omarafif-ee/400V-SiC-Half-Bridge-Driver/Manufacturing/BOM.csv

Reference | Qty | Value | Exclude from Position Files | Footprint | Datasheet | # | Part Number | Manufacturer
C1,C4,C6 | 3 | 100nF | ${EXCLUDE_FROM_POS_FILES} | Capacitor_SMD:C_0805_2012Metric |  | 1 | GRM21BR71H104KA01L | Murata
C2,C5,C7 | 3 | 1uF | ${EXCLUDE_FROM_POS_FILES} | Capacitor_SMD:C_0805_2012Metric |  | 2 | GRM21BR71H105KA12L | Murata
C3 | 1 | 2.2nF | ${EXCLUDE_FROM_POS_FILES} | Capacitor_SMD:C_0805_2012Metric |  | 3 | GRM21BR71H222KA01L | Murata
C8 | 1 | 100nF | ${EXCLUDE_FROM_POS_FILES} | Capacitor_THT:C_Rect_L18.0mm_W6.0mm_P15.00mm_FKS3_FKP3 |  | 4 | MKP1J031004B00KSSD | WIMA
D1 | 1 | UF4007 | ${EXCLUDE_FROM_POS_FILES} | Diode_THT:D_DO-41_SOD81_P10.16mm_Horizontal |  | 5 | UF4007 | Generic
D2,D3 | 2 | 1N5819HW | ${EXCLUDE_FROM_POS_FILES} | Diode_SMD:D_SOD-123 |  | 6 | 1N5819HW | Generic
J1 | 1 | Conn_01x02 | ${EXCLUDE_FROM_POS_FILES} | Connector_PinHeader_2.54mm:PinHeader_1x02_P2.54mm_Vertical |  | 7 | 1x02 Male Header 2.54mm | Generic
J2 | 1 | Conn_01x04 | ${EXCLUDE_FROM_POS_FILES} | Connector_PinHeader_2.54mm:PinHeader_1x04_P2.54mm_Vertical |  | 8 | 1x04 Male Header 2.54mm | Generic
J3 | 1 | 1766136 | ${EXCLUDE_FROM_POS_FILES} | Connector_Phoenix_GMSTB:PhoenixContact_GMSTBA_2,5_3-G-7,62_1x03_P7.62mm_Horizontal |  | 9 | 1766246 | Phoenix Contact
Q1,Q2 | 2 | C3M0120090D | ${EXCLUDE_FROM_POS_FILES} | Package_TO_SOT_THT:TO-247-3_Vertical |  | 10 | C3M0120090D | Wolfspeed
R1 | 1 | 22k | ${EXCLUDE_FROM_POS_FILES} | Resistor_SMD:R_0805_2012Metric |  | 11 | RC0805FR-0722KL | Yageo
R2,R5 | 2 | 10 | ${EXCLUDE_FROM_POS_FILES} | Resistor_SMD:R_0805_2012Metric |  | 12 | RC0805FR-0710RL | Yageo
R3,R6 | 2 | 1 | ${EXCLUDE_FROM_POS_FILES} | Resistor_SMD:R_0805_2012Metric |  | 13 | RC0805FR-071RL | Yageo
R4,R7 | 2 | 10k | ${EXCLUDE_FROM_POS_FILES} | Resistor_SMD:R_0805_2012Metric |  | 14 | RC0805FR-0710KL | Yageo
R8 | 1 | 2.2 | ${EXCLUDE_FROM_POS_FILES} | Resistor_SMD:R_0805_2012Metric |  | 15 | RC0805FR-072R2L | Yageo
R9,R10 | 2 | 220k | ${EXCLUDE_FROM_POS_FILES} | Resistor_THT:R_Axial_DIN0207_L6.3mm_D2.5mm_P10.16mm_Horizontal |  | 16 | MFR-25FTE52-220K | Yageo
U1 | 1 | UCC21520DW | ${EXCLUDE_FROM_POS_FILES} | Package_SO:SOIC-16W_7.5x10.3mm_P1.27mm | http://www.ti.com/lit/ds/symlink/ucc21520.pdf | 17 | UCC21520DW | Texas Instruments
