omarafif-ee/400V-SiC-Half-Bridge-Driver/LTspice_Simulation/SiC_HalfBridge.asc

C8: cap; 100n; Rser=50m
D2: diode; 1N5819
D3: diode; 1N5819
L_load: ind; 200µ; Rser=20
L_loop: ind; 20n; Rser=0.05 Rpar=20
Q1: nmos; C3M0120090D
Q2: nmos; C3M0120090D
R2: res; 10
R3: res; 1
R4: res; 10k
R5: res; 10
R6: res; 1
R7: res; 10k
R9: res; 220k
R10: res; 220k
V_bus: voltage; 400; Rser=0.05
V_OUTA: voltage; PULSE(0 14 1u 15n 15n 4u 10u)
V_OUTB: voltage; PULSE(15 0 0.78u 15n 15n 4.44u 10u)
Named nets: 0, SW_NODE, DC_PLUS, HS_GATE, LS_GATE
.model C3M0120090D VDMOS(Rg=4.7 Vto=2.1 Rd=0.08 Rs=0.04 Rb=0.05 Kp=12 Cgdmax=180p Cgdmin=6p Cgs=310p Cjo=300p Is=1p N=6.5 Vj=4.8 m=0.5 ksubthres=0.1)
.tran 0 20u 0 1n
