omarafif-ee/400V-SiC-Half-Bridge-Driver/Hardware_KiCad/Gate Driver.kicad_pcb

## KiCad design Hardware_KiCad/Gate Driver.kicad_pcb (2026-10-15)

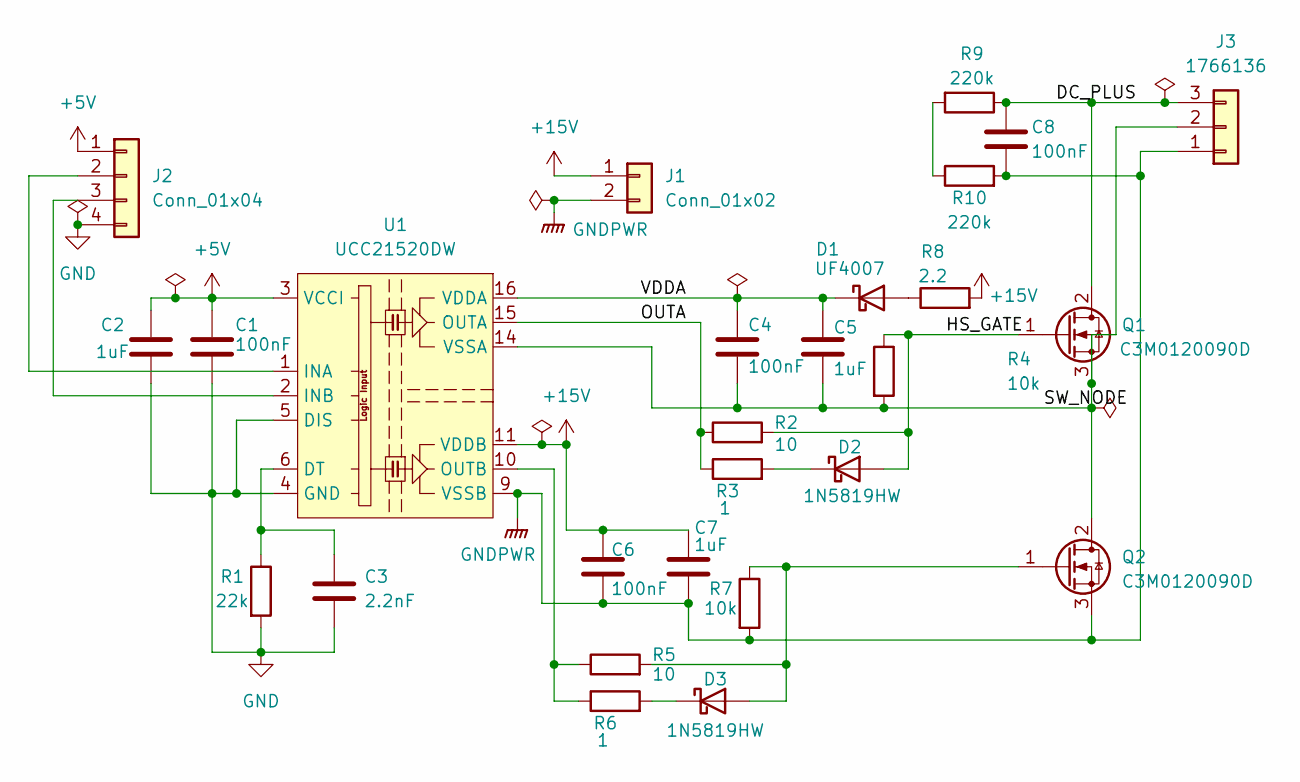
[picture p14: schematic Gate Driver.kicad_sch]

Parts:
C1, C4, C6: 100nF; C_0805_2012Metric; Part Number GRM21BR71H104KA01L
C2, C5, C7: 1uF; C_0805_2012Metric; Part Number GRM21BR71H105KA12L
C3: 2.2nF; C_0805_2012Metric; Part Number GRM21BR71H222KA01L
C8: 100nF; C_Rect_L18.0mm_W6.0mm_P15.00mm_FKS3_FKP3; Part Number MKP1J031004B00KSSD
D1: UF4007; D_DO-41_SOD81_P10.16mm_Horizontal; Part Number UF4007
D2, D3: 1N5819HW; D_SOD-123; Part Number 1N5819HW
J1: Conn_01x02; PinHeader_1x02_P2.54mm_Vertical; Part Number 1x02 Male Header 2.54mm
J2: Conn_01x04; PinHeader_1x04_P2.54mm_Vertical; Part Number 1x04 Male Header 2.54mm
J3: 1766136; PhoenixContact_GMSTBA_2,5_3-G-7,62_1x03_P7.62mm_Horizontal; Part Number 1766246
Q1, Q2: C3M0120090D; TO-247-3_Vertical; Part Number C3M0120090D
R1: 22k; R_0805_2012Metric; Part Number RC0805FR-0722KL
R2, R5: 10; R_0805_2012Metric; Part Number RC0805FR-0710RL
R3, R6: 1; R_0805_2012Metric; Part Number RC0805FR-071RL
R4, R7: 10k; R_0805_2012Metric; Part Number RC0805FR-0710KL
R8: 2.2; R_0805_2012Metric; Part Number RC0805FR-072R2L
R9, R10: 220k; R_Axial_DIN0207_L6.3mm_D2.5mm_P10.16mm_Horizontal; Part Number MFR-25FTE52-220K
U1: UCC21520DW; SOIC-16W_7.5x10.3mm_P1.27mm; Part Number UCC21520DW

Connections:
+5V: C1.1, C2.1, J2.1, U1.3 (VCCI), U1.8 (VCCI)
+15V: C6.1, C7.1, J1.1, R8.2, U1.11 (VDDB)
/DC_PLUS: C8.1, J3.3, Q1.2 (D), R9.1
/HS_GATE: D2.2 (A), Q1.1 (G), R2.2, R4.1
/OUTA: R2.1, R3.1, U1.15 (OUTA)
/SW_NODE: C4.2, C5.2, J3.2, Q1.3 (S), Q2.2 (D), R4.2, U1.14 (VSSA)
/VDDA: C4.1, C5.1, D1.1 (K), U1.16 (VDDA)
GND: C1.2, C2.2, C3.2, J2.4, R1.2, U1.4 (GND), U1.5 (DIS)
GNDPWR: C6.2, C7.2, C8.2, J1.2, J3.1, Q2.3 (S), R7.2, R10.2, U1.9 (VSSB)
unnamed: D1.2 (A), R8.1
unnamed: D2.1 (K), R3.2
unnamed: D3.2 (A), Q2.1 (G), R5.2, R7.1
unnamed: D3.1 (K), R6.2
unnamed: J2.2, U1.1 (INA)
unnamed: J2.3, U1.2 (INB)
unnamed: R9.2, R10.1
unnamed: C3.1, R1.1, U1.6 (DT)
unnamed: R5.1, R6.1, U1.10 (OUTB)

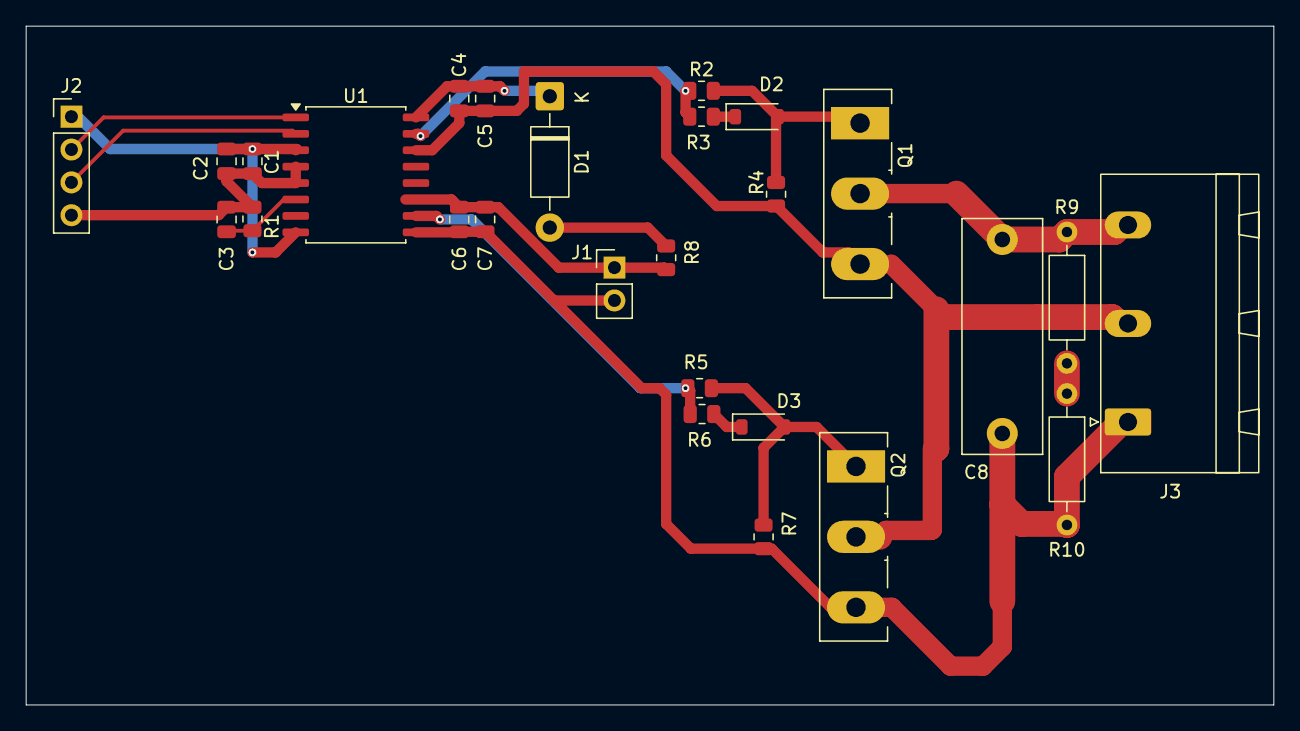
[picture p15: board Gate Driver.kicad_pcb from above]

Board: 2 copper layers, 96.5 x 52.5 mm, 27 parts (0 on the bottom side), 18 nets.
